ANonABento/trash-can-robot/(commit log)

2026-09-27 Implement ESP32 firmware and ROS2 stack for trash can robot
    ESP32-S3 firmware: MJPEG camera stream, UDP motor control, VL53L0X
    obstacle safety in a FreeRTOS task, MPU-6050 IMU init, LED heartbeat.
    ROS2 Python package: camera_node (MJPEG->Image), motor_node
    (Twist->differential drive UDP), teleop_key_node (WASD), and
    safety_monitor_node (speed clamping + logging). Launch files for
    bringup and teleop. Foxglove Studio layout for visualization.
2026-09-27 Remove ToF/IMU — not in purchased hardware
2026-09-27 Add ArduinoJson dependency to platformio.ini
2026-09-27 Fix camera pins for FORIOT ESP32-S3-WROOM N16R8; reassign motor pins to avoid conflicts
2026-09-28 Add serial CAPTURE command for camera sanity check
    Sends a JPEG frame as base64 over serial when it receives CAPTURE\n.
    Includes capture.py script to trigger it and save the result locally.
2026-09-28 Add motor command failsafe, WiFi AP fallback, and serial motor test
    - ESP32 stops the motors when no command arrives for 300 ms; a
    dedicated task now owns the motor pins
    - motor_node re-sends the latest command at 20 Hz and sends zeros once
    /cmd_vel_safe has been quiet for 0.6 s
    - WiFi gives up after 15 s and hosts a "trashcan-bot" AP instead of
    blocking forever
    - Move motor pins off USB D-/D+ (19/20), strapping pin 45 and the RGB
    LED pin 48
    - Add MOTOR/STOP serial commands for bench testing without WiFi
    - Fix the README pin table and the stale ToF safety claims
    [main.cpp]
2026-09-28 Log WiFi disconnect reason codes on join failure
    [main.cpp]
2026-09-28 Add Mac helper to join the ESP32 NAT router AP with fallback
2026-09-28 Disable WiFi modem sleep once connected to cut command latency
2026-09-28 Add parametric OpenSCAD chassis for the cutting-board base
    [params.scad, robot.scad]
2026-09-28 Replace ball casters with one printed rear swivel caster
    Drive axle moves forward so the can's weight sits inside the wheel-wheel-caster
    triangle; front skids catch it on hard braking. The caster takes a 608 bearing
    or a printed bushing of the same size.
    [params.scad, robot.scad]
2026-09-28 Keep the board's handle hole clear at the back
    The rear can tab becomes a bar whose feet bolt down either side of the hole,
    the caster moves forward for finger room, and the render warns if any bolt or
    mount lands on the slot.
    [params.scad, robot.scad]
2026-09-28 Split the can tabs into single-slot pairs and give the front pair googly eyes
    Each side now has two tabs with one M4 slot each, 8 bolts total. The slot runs
    under a gap in the wall so the bolt stays close to the can and a hex key
    reaches it from above. The rear pair flanks the handle hole, replacing can_bar.
    The front pair carries 45mm googly eyes on stalks: a white housing, plus a black
    pupil whose stem is held by a pressed-on washer.
    [params.scad, robot.scad]
2026-09-28 Bolt the camera cradle through the 7mm board and add a rail fit-test slice
    The board is measured at 357mm across and 7mm thick, which is too thin to hold
    wood screws. The cradle now takes M3 countersunk bolts from the top, with the
    nuts trapped in its flange. cam_fit_test prints the channel's free end on its
    own, so the PCB fit can be checked in minutes.
    [params.scad, robot.scad]
2026-09-28 Shelve the googly eyes and use the listing's ESP32-S3-CAM dimensions
    The camera is going sideways so its USB ports can plug in, which puts the lens
    off-center and breaks the face.
    [params.scad]
2026-09-28 Sideways ESP32-S3-CAM cradle: antenna-tab pocket, USB-end block, corner snap hooks, open back
    [params.scad, robot.scad]
2026-09-28 Hold the ESP32 by its corner holes with M2.5 screws instead of snap hooks
    [params.scad, robot.scad]
2026-09-28 Face-mount printed motor bracket replaces the gearbox clamp; ESP32 width to 28.1
    The gearbox face screws to a plate through 6 slotted M3 holes (27-32 PCD),
    the flange bolts through the board with 4x M3 + nut, two ribs tie them.
    The plate sits between gearbox and wheel, so the motor moves inboard by its
    thickness and the wheel set screw moves to the middle of the shaft it gets.
    Motor cradle switched to board bolts. ESP32 width from the listing (28.1):
    the 27 tape measurement made the cradle too tight.
    [params.scad, robot.scad]
2026-09-28 Motor bracket: drop case-screw clearance holes, gearbox face is flush
    [params.scad, robot.scad]
2026-09-28 Camera cradle: antenna side blocks stop 2mm short of the PCB shoulders
    They ended 0.3mm from the shoulders, so any error in the photo-guessed tab
    length made them the x stop instead of the screw holes, pushing the board out
    past the USB block and onto its headers.
    [robot.scad]
2026-09-29 Camera cradle: widen the antenna pocket to 20.9mm
    The tab scales to ~19.3mm wide off the fit photo, not the 18 guessed earlier,
    so it bound on the side blocks. Add 0.5mm per side on top; the screws locate.
    [params.scad, robot.scad]
2026-09-29 Camera cradle: 3mm of room past the antenna tip (was 1.5)
    [robot.scad]
2026-09-29 Camera cradle: model the ESP32 at the listing's 67.6mm, deepen the tab pocket
    The board kept sitting ~1mm past the USB block even with the pocket loosened,
    so the corner holes overshot the pilots. At 67.6 the pilots move 1.6mm out:
    anything short of that the board slides out to meet, which is always free.
    Tip room 3.3 -> 4.8mm, side blocks now 3.5mm short of the shoulders.
    [params.scad, robot.scad]
2026-09-29 ESP32 holes 25mm apart (1.6 from the long edges); looser M3 nut traps
    The corner holes scale to 1.6mm from the long edges off the fit photo, not
    2.5. Nut traps go from 5.8 to 6.1mm across flats and 2.8 to 3.0mm deep.
    [params.scad, robot.scad]
2026-09-29 Camera cradle: tighten after fit test
    Holes 24.5mm apart (25 was slightly wide), 2.3mm tip room (4.8 was loose),
    side blocks 2mm short of the shoulders, and only the 0.3 fit beside the tab
    (there was ~1mm of play).
    [params.scad, robot.scad]
2026-09-29 Electronics mounts: listing dims for L298N holes, power bank size
    [params.scad]
2026-10-02 Camera cradle: usb_shift moves the USB-end block toward the antenna
    [robot.scad]
2026-10-02 README: keep the L298N 5V jumper on; set the buck to 5V before connecting the ESP32
